rishigovindnair-web/RishiStarbie/production/BOM.csv

Ref | Part | Qty needed | Qty bought | Unit price (USD) | Line total (USD) | Vendor | Link | Footprint | Notes
U1 | Seeed XIAO ESP32-C3 | 1 | 1 | 4.99 | 4.99 | Seeed Studio | https://www.seeedstudio.com/Seeed-XIAO-ESP32C3-p-5431.html | Imported Parts:XIAO-ESP32-C3-DIP | USB-C faces the bottom edge
- | 7-pin male header for XIAO (5 pcs) | 18 pins | 1 pack | 0.20 | 0.20 | Seeed Studio | https://www.seeedstudio.com/XIAO-Series-7-Pin-Male-Header-5-pcs-p-5460.html | - | 2 strips for the XIAO; snap 4 pins off a spare for the OLED if it has none
J1 | 0.96in SSD1306 OLED 128x64 I2C, white (GND-VCC-SCL-SDA pin order) | 1 | 1 | 1.09 | 1.09 | AliExpress (Estardyn) | https://www.aliexpress.us/item/3256806851877676.html | Imported Parts:Display_128x64_096_I2C | Check your module's pin order matches GND VCC SCL SDA
J2 | GY-521 MPU6050 module | 1 | 1 | 3.15 | 3.15 | AliExpress (AOKIN) | https://www.aliexpress.us/item/3256809115197759.html | Imported Parts:MPU6050_Module | Powered from 3.3V; 8-pin header included
U2 | DHT11 bare 4-pin sensor | 1 | 1 | 2.33 | 2.33 | AliExpress | https://www.aliexpress.us/item/3256806638028537.html | Sensor:Aosong_DHT11_5.5x12.0_P2.54mm | Option 'DHT11', not the module/breakout board
R1 | 10k resistor 1/4W metal film (DHT11 data pull-up) | 1 | 1 pack of 100 | 1.02 | 1.02 | AliExpress (TriArk) | https://www.aliexpress.us/item/3256807353528247.html | Resistor_THT:R_Axial_DIN0204_L3.6mm_D1.6mm_P7.62mm_Horizontal
SW1 SW2 | Gateron G Pro 3.0 Blue switch (MX-compatible, clicky) | 2 | 1 pack of 10 | 2.85 | 2.85 | AliExpress | https://www.aliexpress.us/item/3256806189709905.html | Button_Switch_Keyboard:SW_Cherry_MX_1.00u_PCB
- | Blank DSA PBT keycaps, 1u (20 pcs, mixed colours) | 2 | 1 pack of 20 | 3.38 | 3.38 | AliExpress | https://www.aliexpress.us/item/3256808640925468.html | -
- | PCB 2-layer 94.7 x 90.4 mm (purple, 1.6 mm, HASL) | 1 | 5 (minimum order) | 0.01 | 0.01 | JLCPCB | production/RishiStarbie_gerbers.zip | - | Fits the 100x100 mm price tier
- | Tax & shipping (all orders) |  |  |  | 7.66 |  |  |  | Seeed 6.30 (shipping 5.80 + tax 0.50), AliExpress 1.36
- | Total |  |  |  | 26.68
