rishigovindnair-web/RishiStarbie/pcb/RishiStarbie.kicad_pcb

## KiCad design pcb/RishiStarbie.kicad_pcb (2026-10-11)

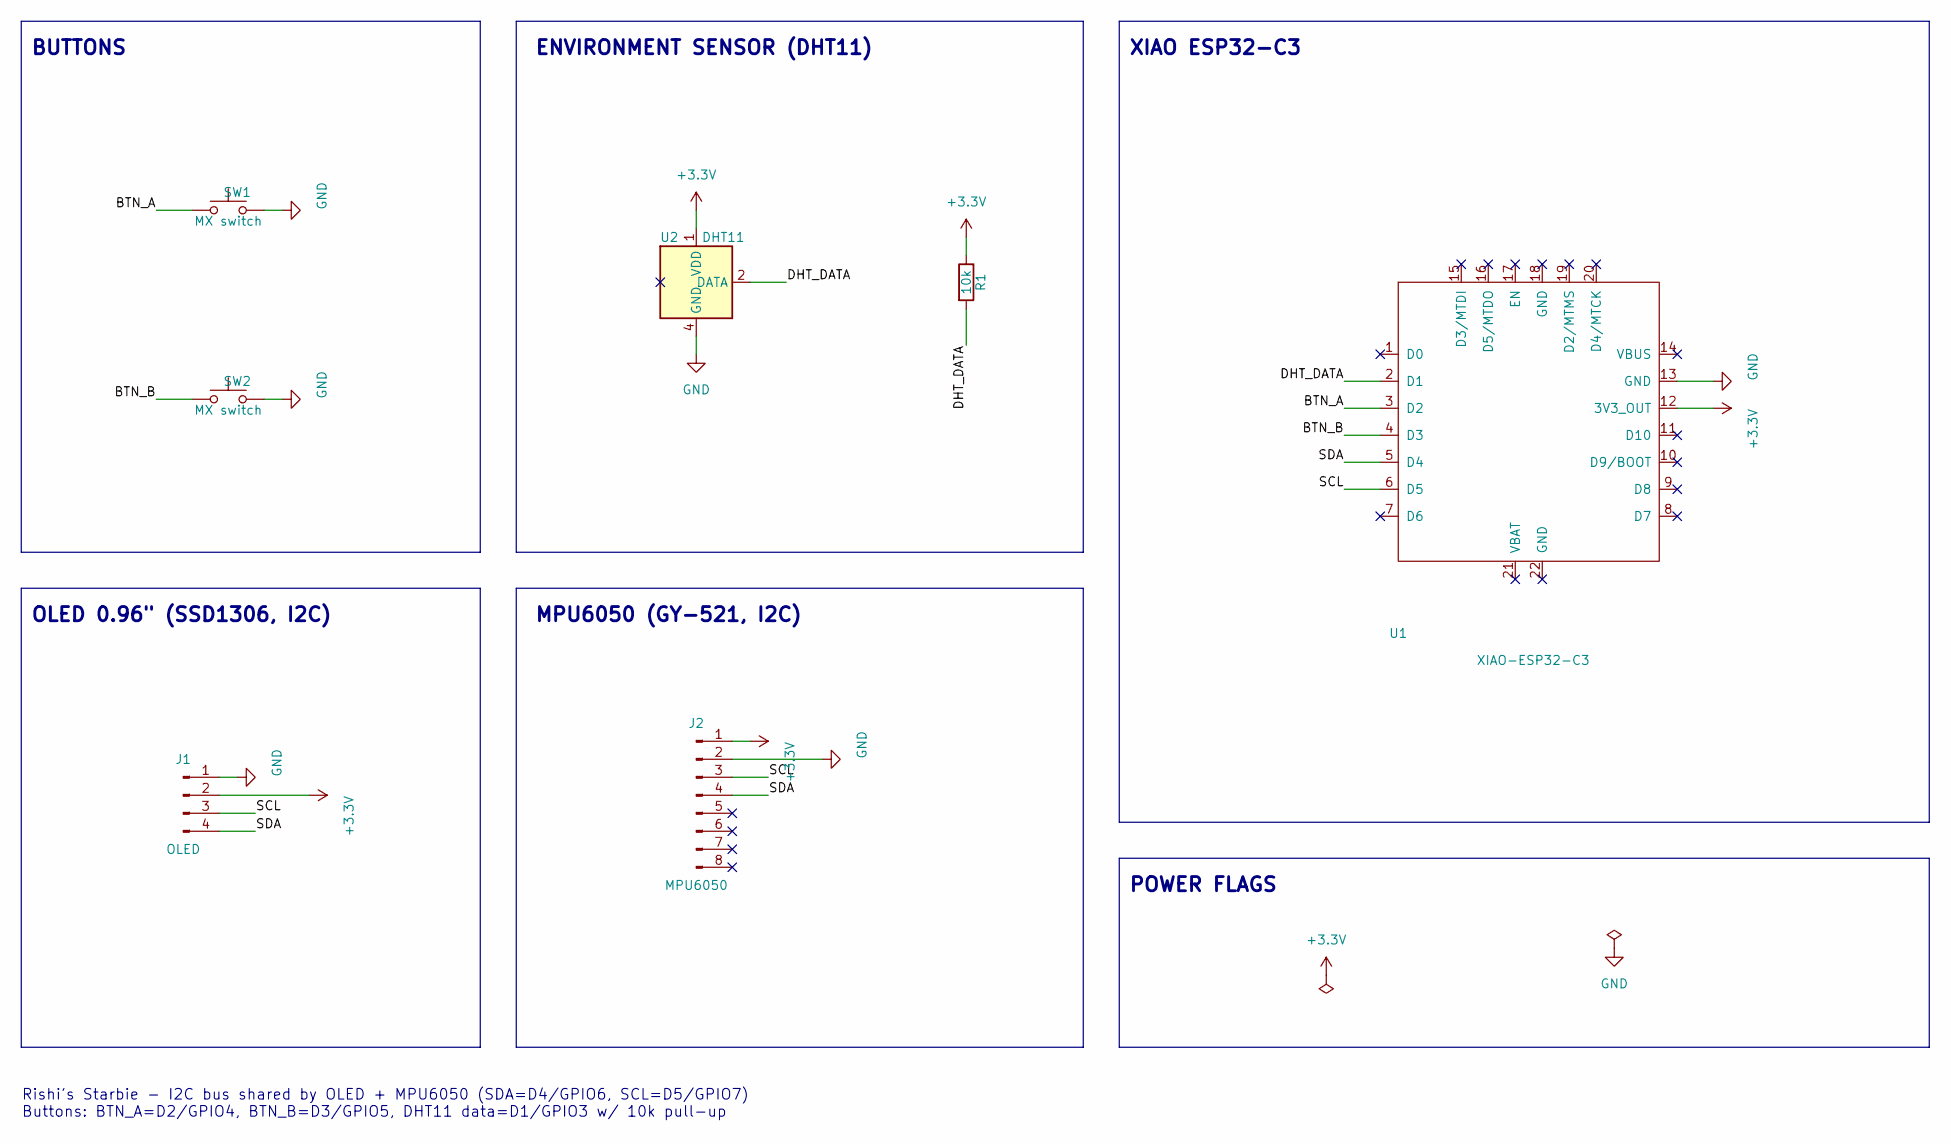
[picture p1: schematic RishiStarbie.kicad_sch, Rishi's Starbie]

Parts:
J1: OLED; Display_128x64_096_I2C
J2: MPU6050; MPU6050_Module
R1: 10k; R_Axial_DIN0204_L3.6mm_D1.6mm_P7.62mm_Horizontal
SW1, SW2: MX switch; SW_Cherry_MX_1.00u_PCB
U1: XIAO-ESP32-C3; XIAO-ESP32-C3-DIP
U2: DHT11; Aosong_DHT11_5.5x12.0_P2.54mm

Connections:
+3.3V: J1.2, J2.1, R1.1, U1.12 (3V3_OUT), U2.1 (VDD)
/BTN_A: SW1.1, U1.3 (D2)
/BTN_B: SW2.1, U1.4 (D3)
/DHT_DATA: R1.2, U1.2 (D1), U2.2 (DATA)
/SCL: J1.3, J2.3, U1.6 (D5)
/SDA: J1.4, J2.4, U1.5 (D4)
GND: J1.1, J2.2, SW1.2, SW2.2, U1.13 (GND), U2.4 (GND)

Notes on the sheet:
BUTTONS
ENVIRONMENT SENSOR (DHT11)
OLED 0.96" (SSD1306, I2C)
MPU6050 (GY-521, I2C)
XIAO ESP32-C3
POWER FLAGS
Rishi's Starbie - I2C bus shared by OLED + MPU6050 (SDA=D4/GPIO6, SCL=D5/GPIO7) Buttons: BTN_A=D2/GPIO4, BTN_B=D3/GPIO5, DHT11 data=D1/GPIO3 w/ 10k pull-up

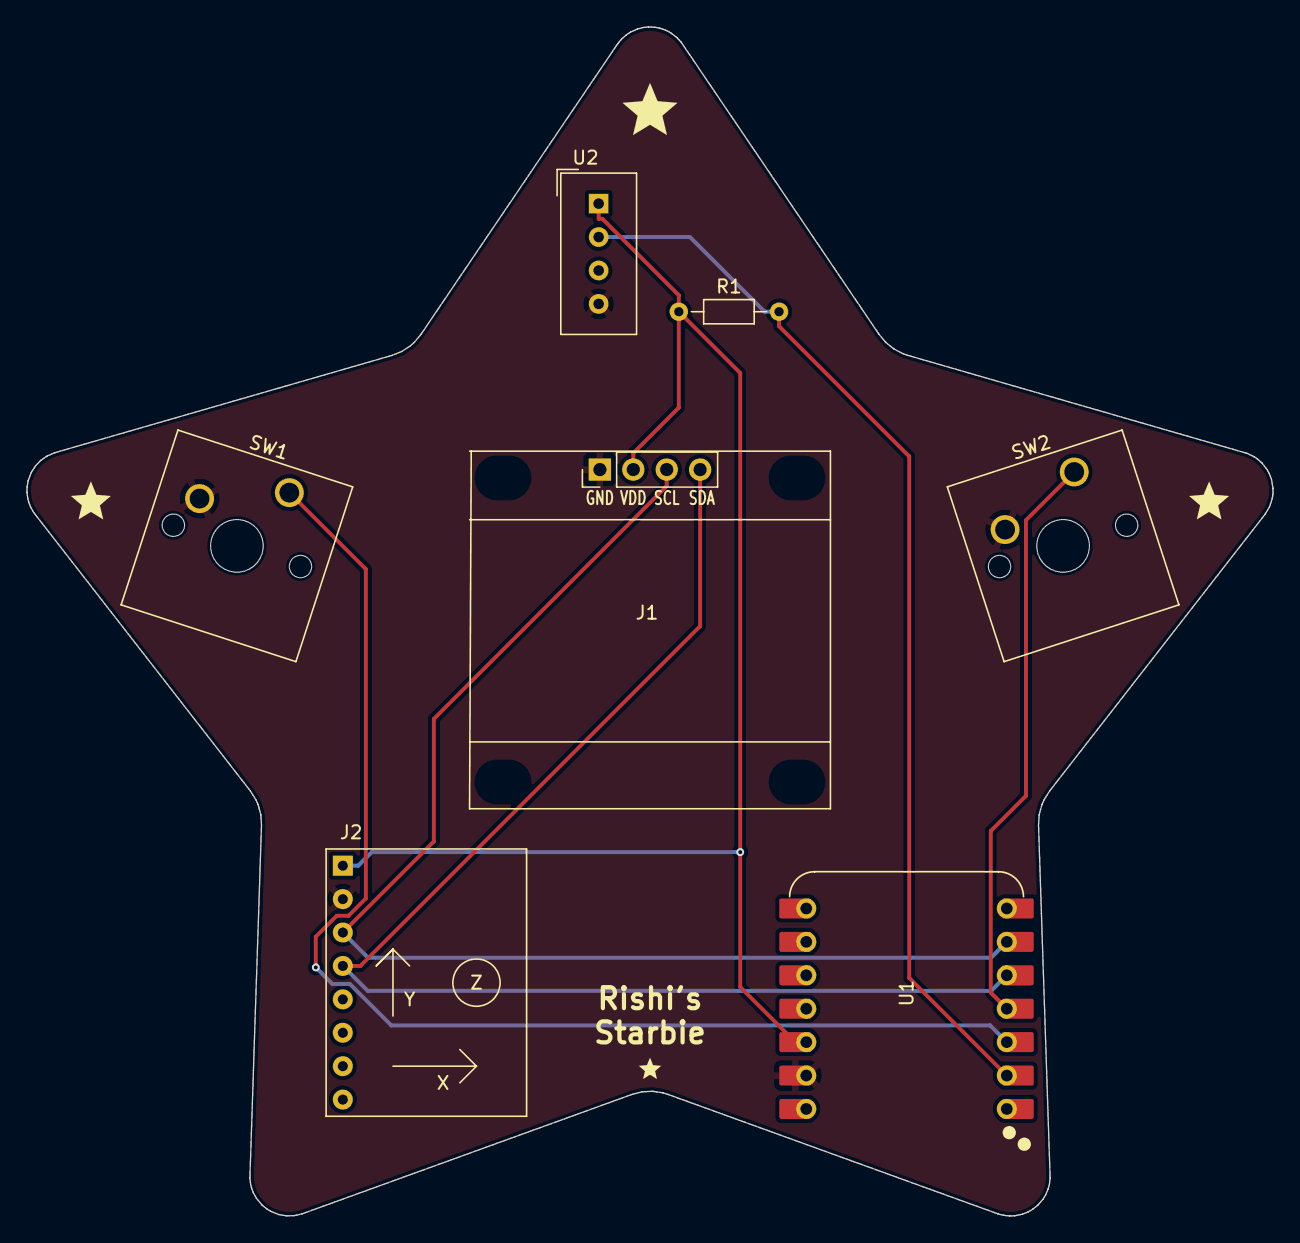
[picture p2: board RishiStarbie.kicad_pcb from above]

Board: 2 copper layers, 94.7 x 90.4 mm, 7 parts (0 on the bottom side), 7 nets.
