rishigovindnair-web/RishiStarbie/(commit log)

2026-10-11 Move KiCad project into pcb/
    [RishiStarbie.kicad_pcb, RishiStarbie.kicad_sch]
2026-10-11 Add Imported Parts footprint library
2026-10-11 Move gerbers and BOM into production/
    [BOM.csv]
2026-10-11 Rewrite README with repo layout and KiCad instructions, add .gitignore
2026-10-11 Move off-board XIAO silkscreen to fab layer, rename footprint to XIAO-ESP32-C3-DIP
    [RishiStarbie.kicad_pcb, RishiStarbie.kicad_sch]
2026-10-11 Add renamed XIAO-ESP32-C3-DIP footprint
2026-10-11 Point XIAO symbol at renamed footprint
2026-10-11 Regenerate gerbers with silkscreen fix, update BOM footprint name
    [BOM.csv]
2026-10-17 Update BOM with ordered prices and vendors
    [BOM.csv]
2026-10-17 BOM: update DHT11 link
    [BOM.csv]
2026-10-17 BOM: switch parts to AliExpress, update prices
    [BOM.csv]
